pitaguillermoec/antichoques-GINM/Prototype.jpeg

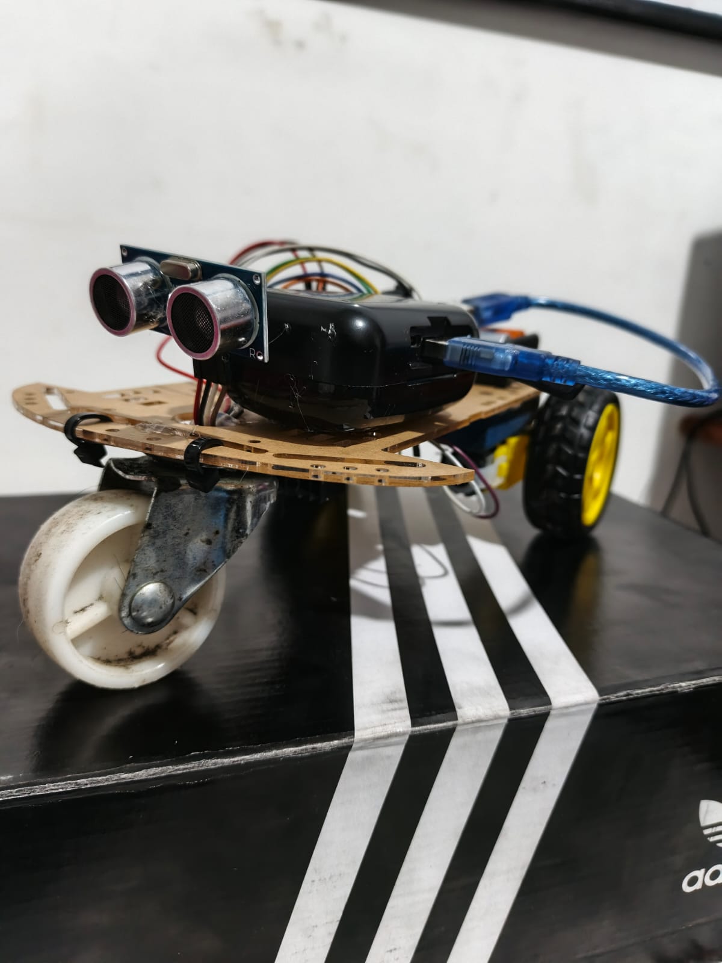
Prototype.jpeg
