pitaguillermoec/antichoques-GINM/L298N.jpeg

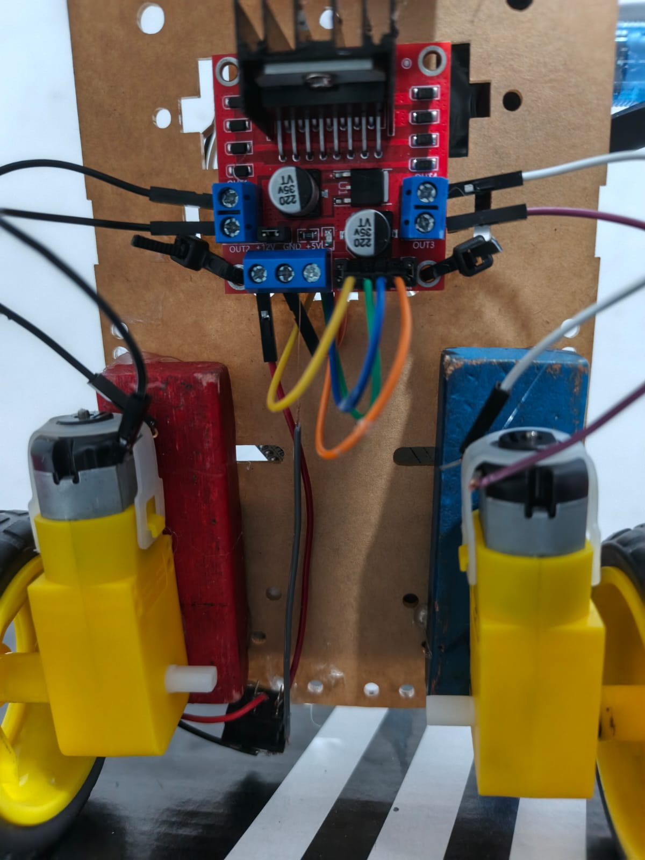
L298N.jpeg
