pitaguillermoec/antichoques-GINM/README.md

# Antichoques GINM - Sistema de Seguridad Perimetral para Robótica



## Descripción
Sistema de control en tiempo real para detección de obstáculos y prevención de colisiones en plataformas robóticas. Utiliza sensores de proximidad y lógica difusa para tomar decisiones de evasión.

## Tecnologías
- **Lenguaje:** C++ (Arduino)
- **Hardware:** Sensores ultrasónicos, microcontrolador ESP32/Arduino
- **Principios:** Control en tiempo real, seguridad perimetral, lógica de evasión

## Funcionalidades
- Detección de obstáculos en múltiples direcciones
- Algoritmo de evasión con priorización de rutas
- Salida a motores DC con control PWM

## Instalación y Uso
1. Clonar repositorio
2. Abrir en Arduino IDE
3. Conectar hardware según esquema 
4. Subir código al microcontrolador

## Pruebas
Resultados de pruebas en diferentes entornos (ver `/images`)

## Autor
PITA L. GUILLERMO (2026) - Estudiante de Bachillerato en Ciencias "Instituto Nacional Mejia"
Intereses: Robótica, Seguridad Informática, DevSecOps

## Licencia
MIT

----------------------
----------------------

# Antichoques GINM - Perimeter Security System for Robotics

## Description
Real-time control system for obstacle detection and collision avoidance in robotic platforms. Uses proximity sensors and fuzzy logic to make evasive decisions.

## Technologies
- **Language:** C++ (Arduino)
- **Hardware:** Ultrasonic sensors, ESP32/Arduino microcontroller
- **Principles:** Real-time control, perimeter security, evasion logic

## Features
- Multi-directional obstacle detection
- Evasion algorithm with route prioritization
- DC motor output with PWM control

## Installation & Usage
1. Clone the repository
2. Open in Arduino IDE
3. Connect hardware according to schematic
4. Upload code to the microcontroller

## Testing
Test results in different environments (see `/images`)

## Author
PITA L. GUILLERMO (2026) - High School Science Student "Instituto Nacional Mejia"
Interests: Robotics, Information Security, DevSecOps

## License
MIT
