pitaguillermoec/antichoques-GINM/(commit log)

2026-03-30 Create robotesquivador.ino
    Código basado en prueba-error de colisión en el robot
2026-03-30 Informe Técnico
    "Manual" de teoría y construcción del GINM (2026)
2026-03-30 Images
    Some "open-heart" circuits of GINM
